sq7bti/AVAGO/cocolino_timing.png

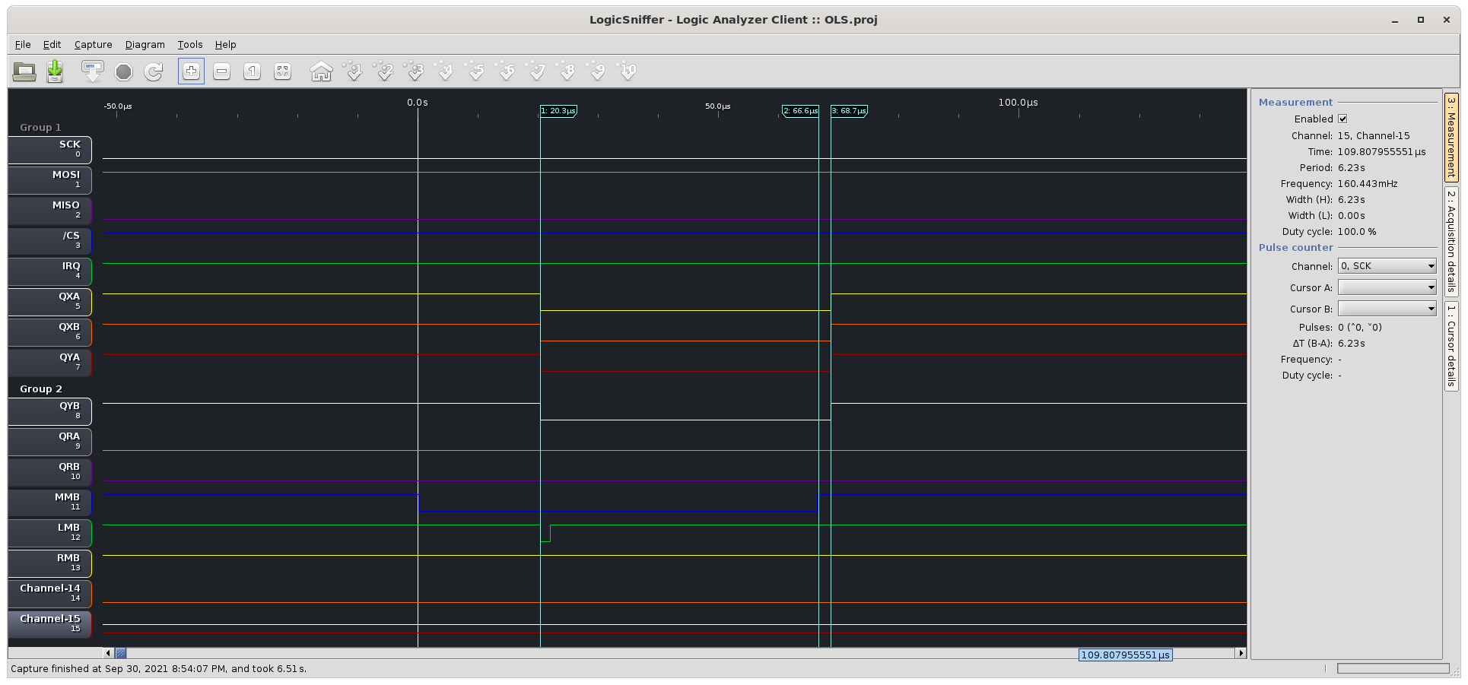
cocolino_timing.png
