sq7bti/AVAGO/mouse_open_1.jpg

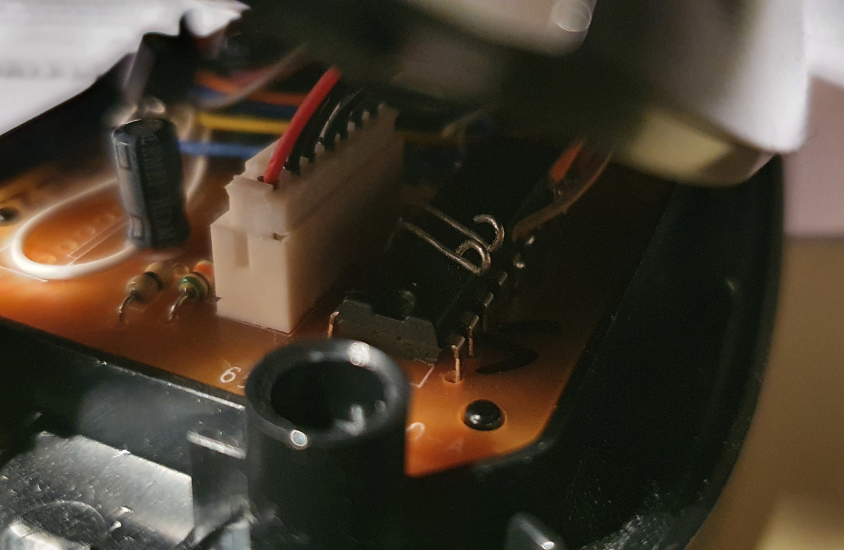
mouse_open_1.jpg
