sq7bti/AVAGO/nogginthenog_timing.png

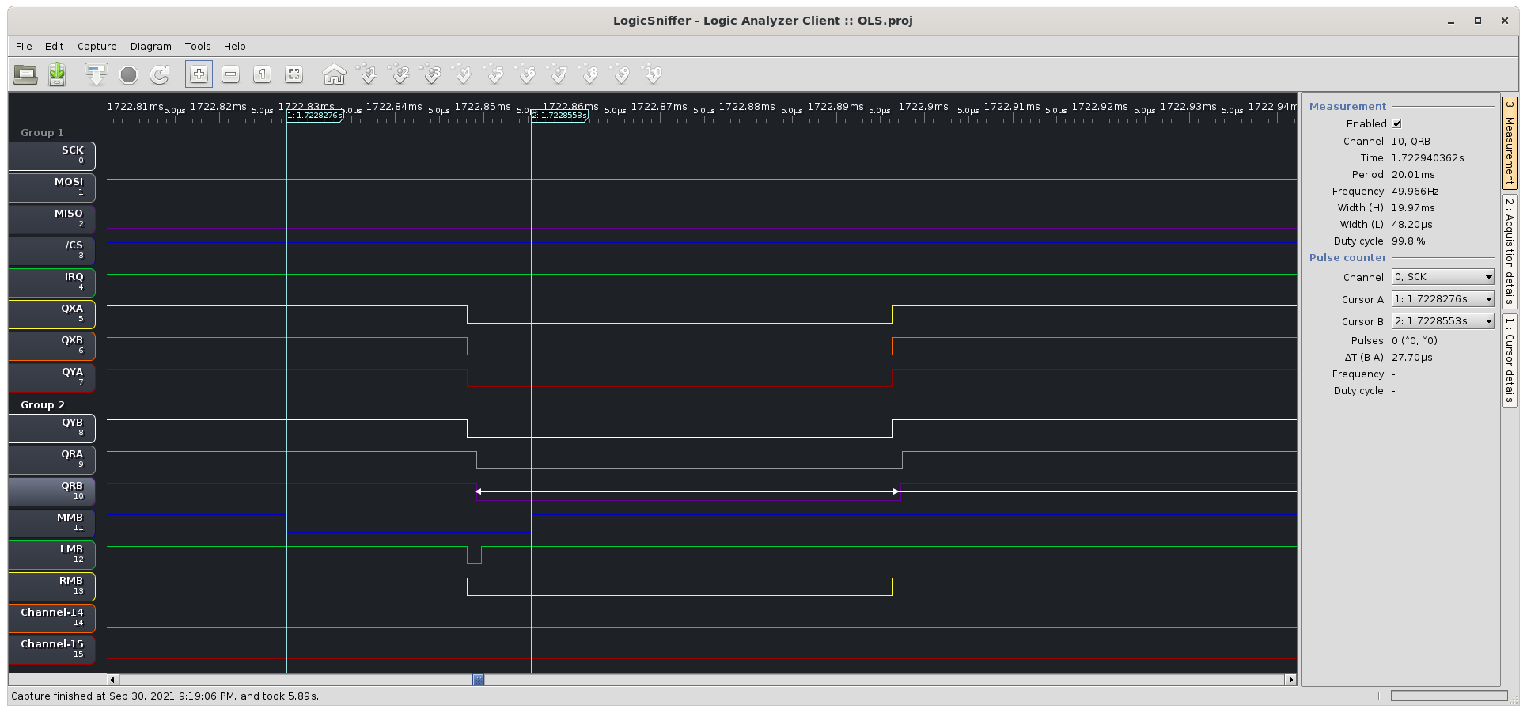
nogginthenog_timing.png
