sq7bti/AVAGO/wheel_up_down_cocolino.png

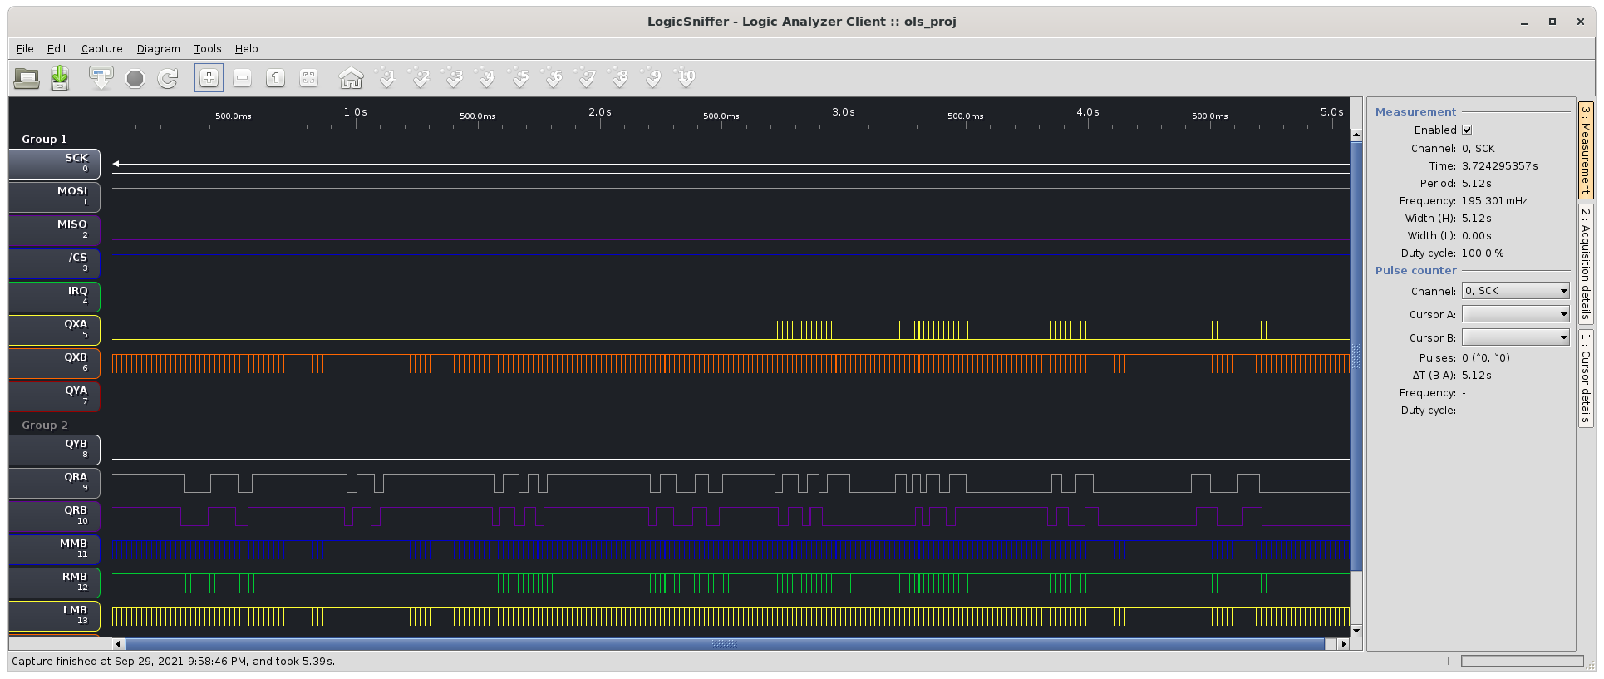
wheel_up_down_cocolino.png
