sq7bti/AVAGO/wheel_up_down_ezmouse.png

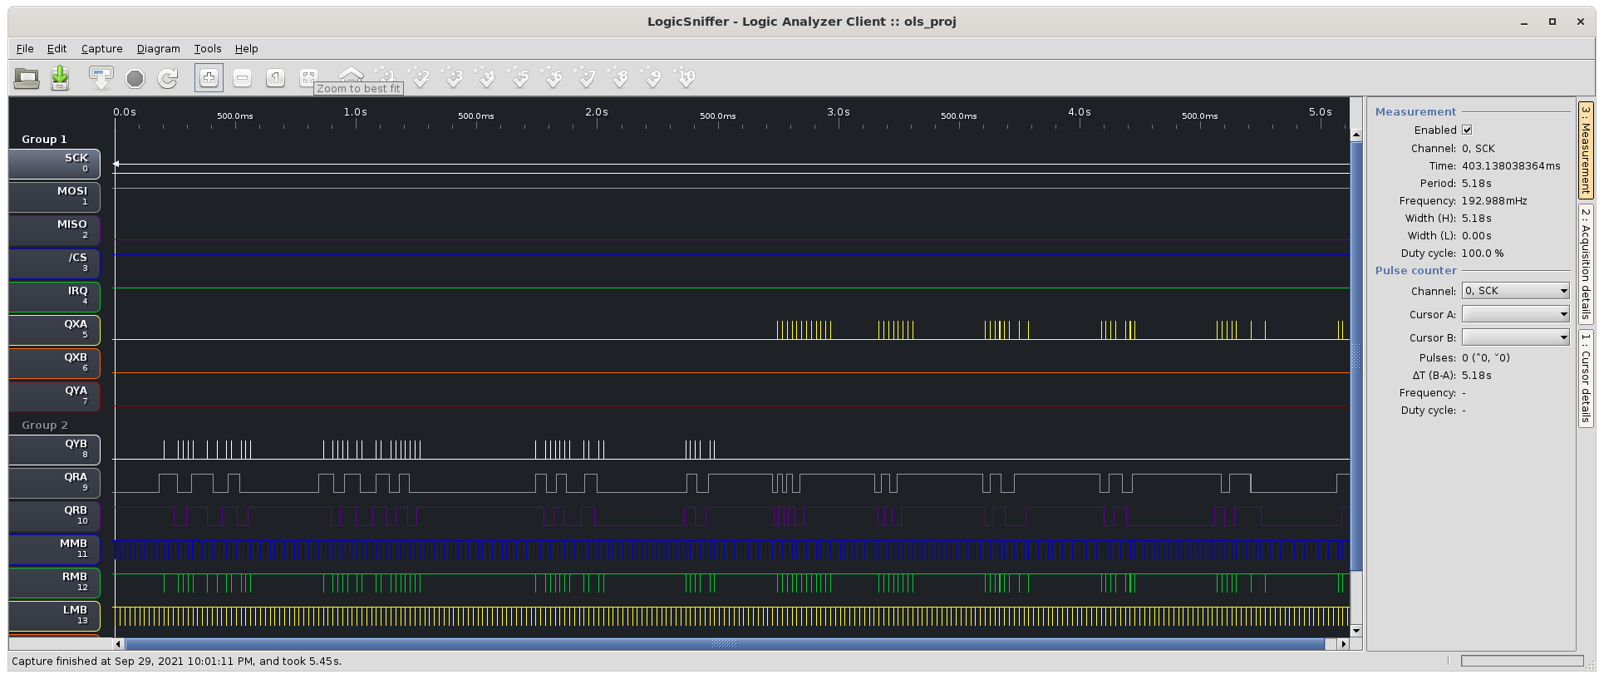
wheel_up_down_ezmouse.png
