sq7bti/AVAGO/laser_calibration.png

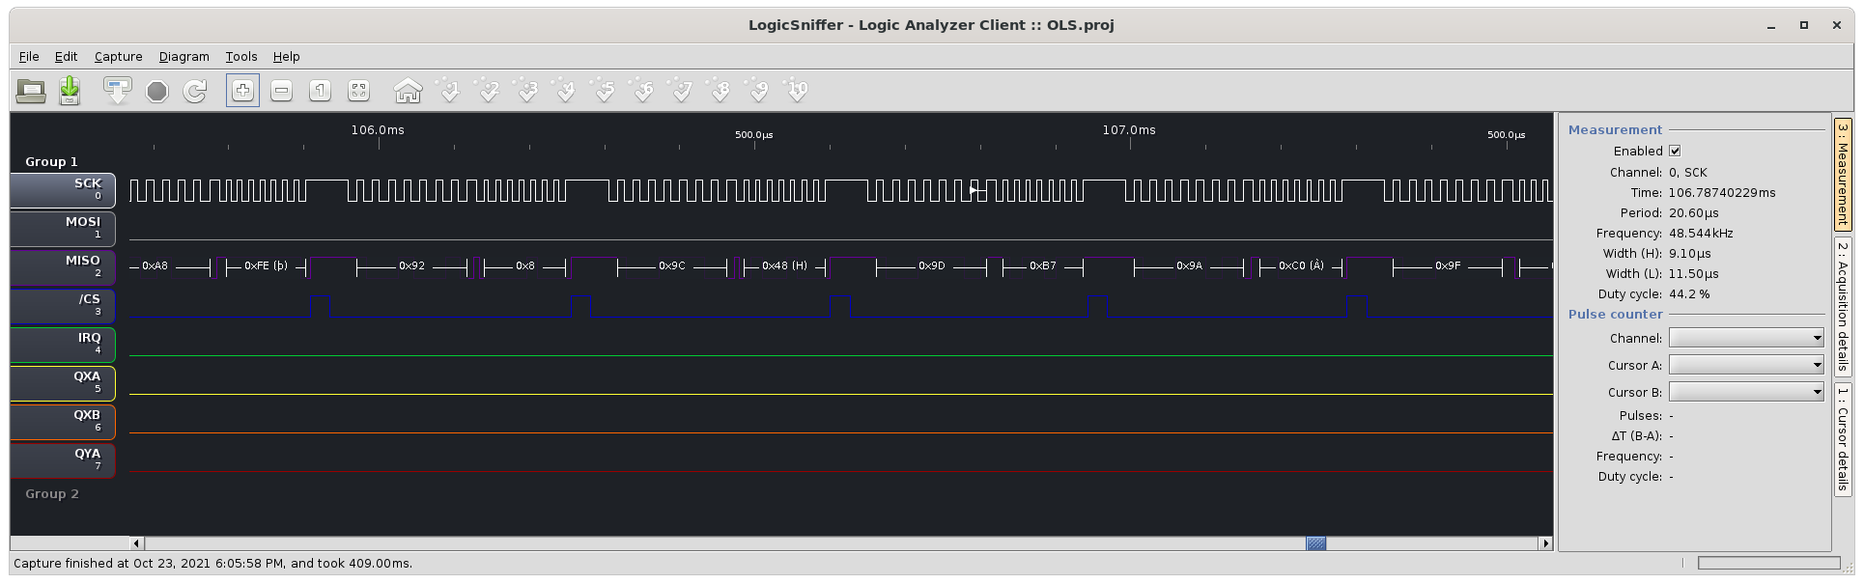
laser_calibration.png
