sq7bti/AVAGO/(commit log)

2021-09-09 decrease CPU clock (it will be supplied with just 3V from ADNS VrefB) to 12MHz set delays, clock dividers accordingly SPI works fine with 2MHz clock - tests will follow REG_LASER_CTRL0 should be mask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
    [AVAGO.ino]
2021-09-13 add quadrature input for scroll and middle mouse button
2021-09-15 sensitivity mode button - support not yet finished scroll roll preliminary support
2021-09-16 corrected input mode for scroll roller quadrature inputs
    [AVAGO.ino]
2021-09-19 use polling instead of interrupts for scrollwheel detection
2021-09-24 scroll wheel support WiP (based on Cocolino protocol)
2021-09-27 code cleanup wheel, middle button, 45h, 5th support - WiP for cocolino, ez-mouse
2021-09-30 add MSP430G2553 (12MHz) to target devices in Energia reshuffle pins to use P2 as outputs for LMB/RMB and quadrature outputs, to optimise interrupt handling make updates to X and Y separatelly for qui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
2021-10-02 use one pin for 3 buttons (MMB, 4th, and 5th)
2021-10-03 trigger motion lookup in case of inactivity and right after MMB pulse
2021-10-03 use loop counter instead of micros (it's not even as good as millis)
2021-10-08 reverse logic on RMB - Paula is too picky to detect RMB when pulled down through low Vf diode - use open-drain or open collector circuit use RED_LED as A0 (5k to 3V pullup) input to detect 3 addition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
    [AVAGO.ino]
2021-10-15 4th and 5th button support on ADC input Blabber protocol uses quadratic signals only
2021-10-23 calibration sniffing
2021-10-24 incorrect wire assignments code swappings
    [AVAGO.ino]
2021-10-27 BUG: incorrect update period calculation for negative movement direction SPI clock lowered to 666kHz retry SPI if MOTION pin not cleared
    [AVAGO.ino]
2021-10-28 first process buttons, then wheel(s)
2021-11-14 WIRING CHANGED! no more cocolino/EZ/etc - just 4 direction cable protocol
2021-11-23 pin assignment
2021-12-12 wire numbering typo
2023-04-23 wiring pinout and spelling
